RickyLiao5083/CVSD_Final_Project/README.md

# 111-2 CVSD_Final_Project
In this final project, we aim to design and implement a ML demodulator in 5G MIMO Demodulation.
This repository includes all files needed and generated amoung the design flow from RTL, synthesis, gate-sim and APR to post-sim as well as power analysis.
