RickyLiao5083/CVSD_Final_Project/APR.png

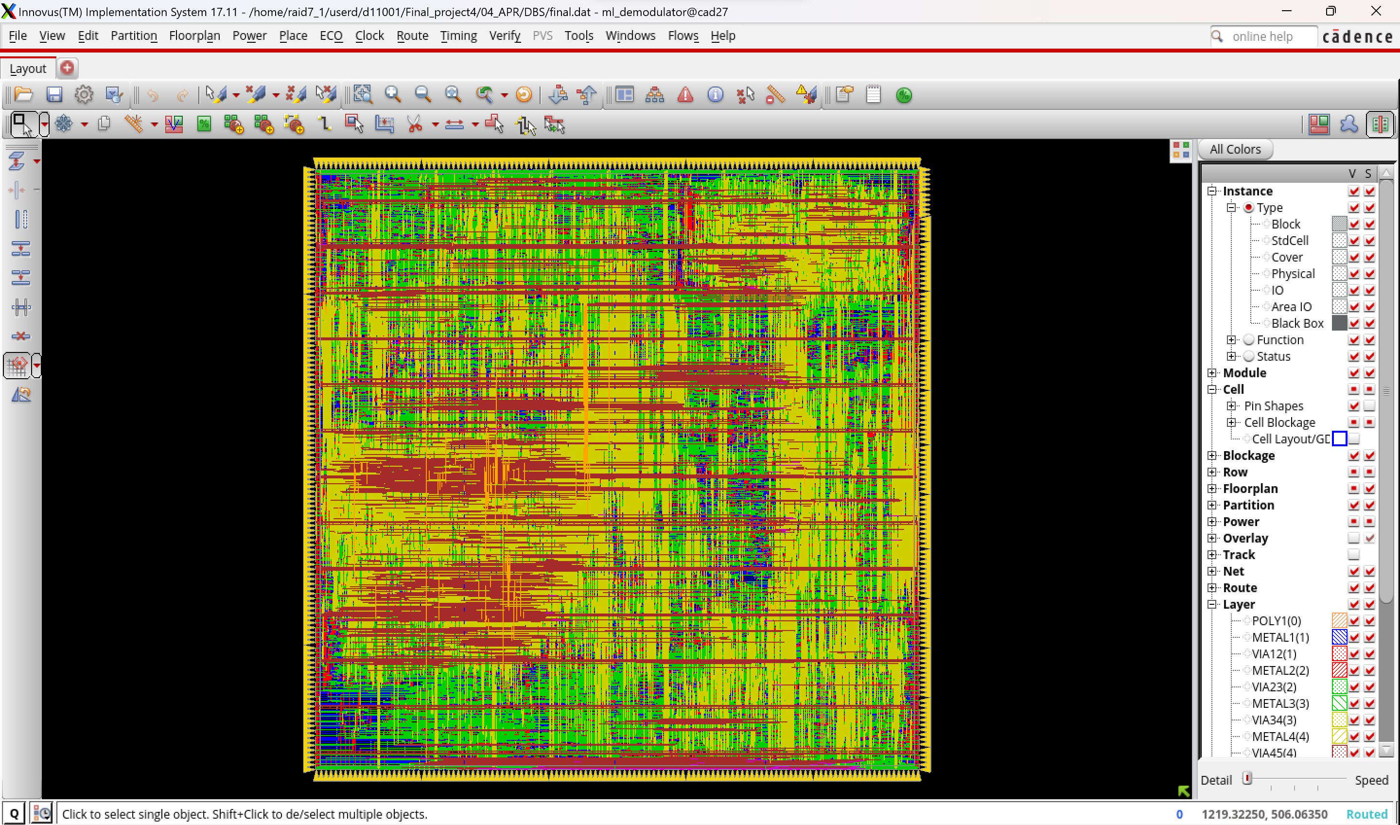
APR.png
